goldiee36/desk-clock/reducePowerConsumption2.jpg

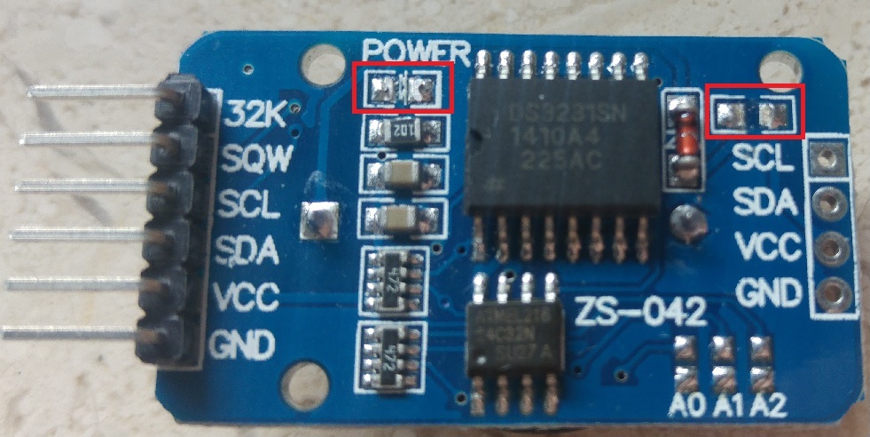
reducePowerConsumption2.jpg
