goldiee36/desk-clock/reducePowerConsumption.jpg

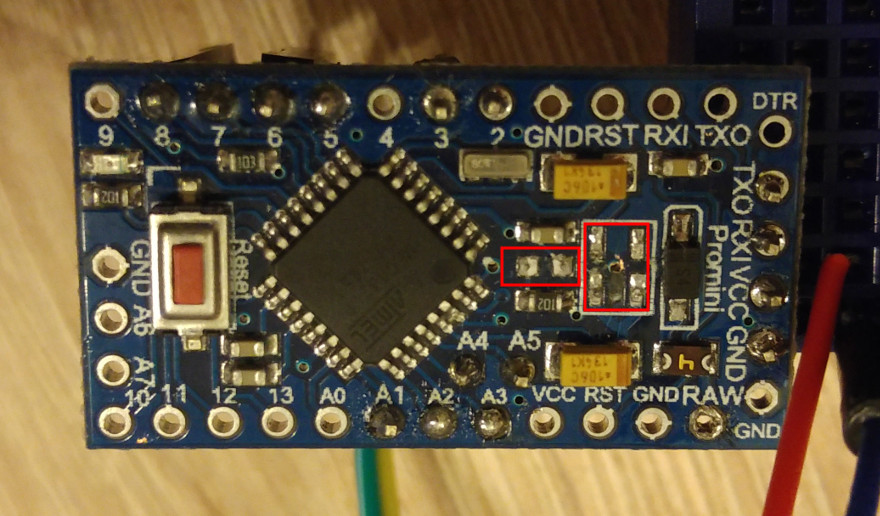
reducePowerConsumption.jpg
