goldiee36/desk-clock/(commit log)

2016-10-31 modded dht lib added, upper left corner temperature, bottom right is humidity.
2016-10-31 wiring in readme corrected
2016-11-01 untested buttons
2016-11-02 buttons mechanism wokring and advanced draw implemented
2016-11-03 ontime updated in readme, ontime currently 80 hours, battery level is 3.62
2017-01-07 low battery oled warnings added
2017-01-10 v0.35 auto-onoff added, contrast fixed
    [desk-clock.ino]
2017-02-11 v0.36 - bug fix - freeze at display off
    [desk-clock.ino]
